statisnomo/RC-Project_P1_G9/evidence/lab_2026-11-04/keypad_setup.jpg

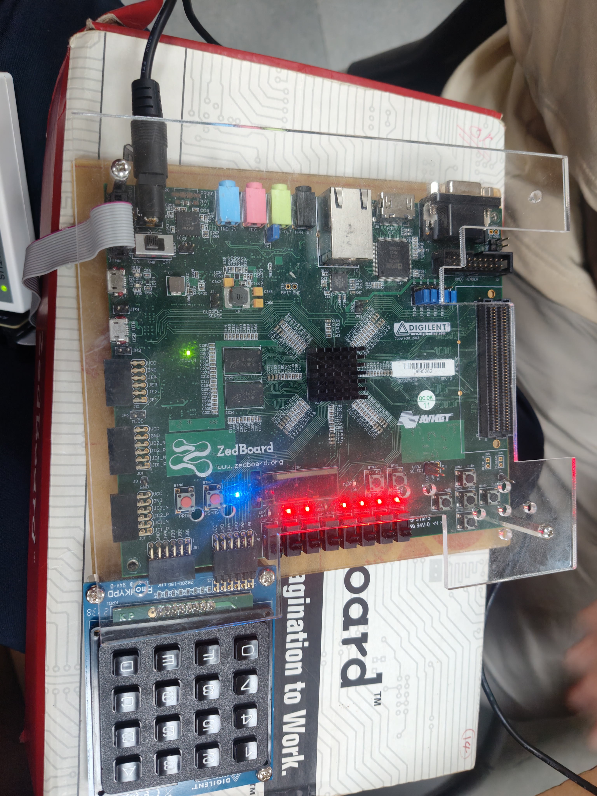
evidence/lab_2026-11-04/keypad_setup.jpg
