statisnomo/RC-Project_P1_G9/evidence/lab_2026-11-04/oled_pattern_close.jpg

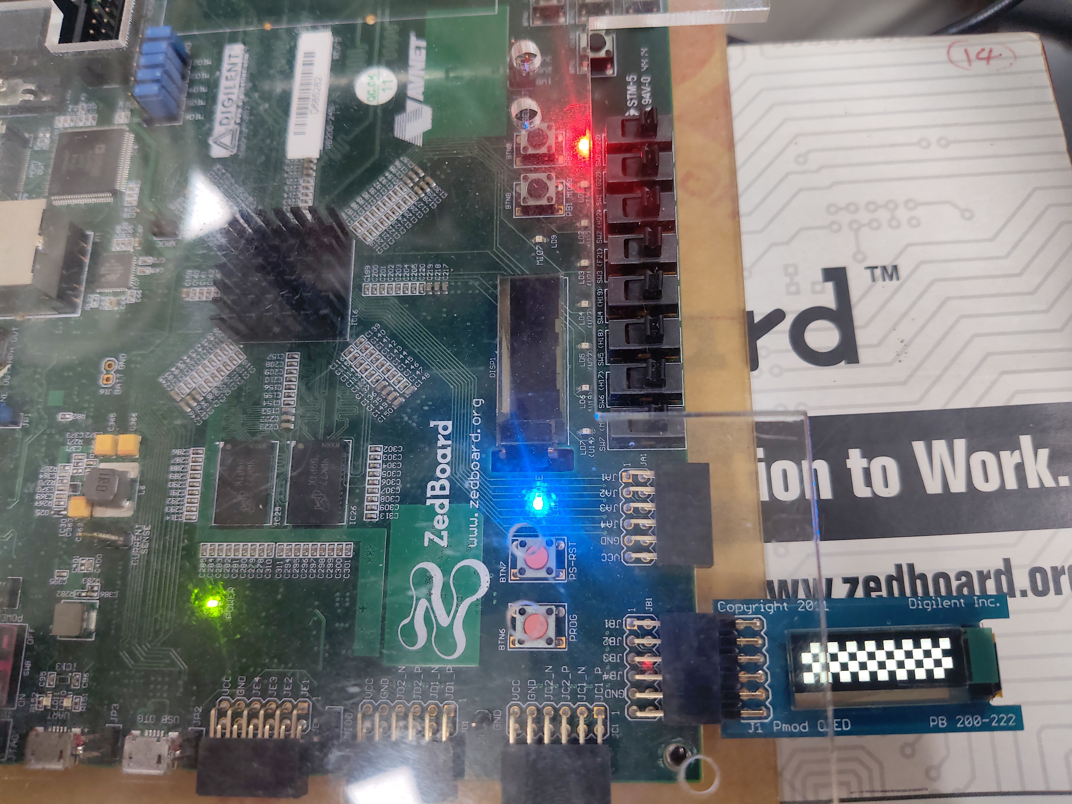
evidence/lab_2026-11-04/oled_pattern_close.jpg
