statisnomo/RC-Project_P1_G9/README.md

# Custom RISC-V SoC with a Cryptographic Hardware Accelerator

**Presentation build — November 6:** the same custom CPU now runs software
AES and controls the hardware AES for a measured comparison: 24,576 versus
213 cycles at wait setting 1. Both paths matched 413 independently checked
inputs in each of two bus configurations. This is simulation-verified; live
OLED comparison integration is next. See [GUI tests 28–30](docs/benchmark.md),
[the presentation plan](docs/presentation_plan.md), and download
[the separate benchmark development ZIP](https://github.com/statisnomo/RC-Project_P1_G9/raw/refs/heads/main/deliverables/riscv_soc_benchmark_dev_2026-11-06.zip).
Open `docs/presentation_demo.html` locally for the offline comparison/bit-change view.

**Next lab:** [hardened JA keypad + JC OLED kit and GUI procedure](NEXT_LAB_COMBINED.md), with tests 21–26 and expanded physical checks. [Optional UART side test](LAB_UART_OPTIONAL.md). [November 4 lab results](docs/lab_results_2026-11-04.md).

**November 5 lab PASS:** tests 21–26 and correctly rendered combined ciphertexts
on the external OLED. [Results and waveform layouts](docs/lab_results_2026-11-05.md).
The next variant uses [the ZedBoard's built-in OLED](LAB_ONBOARD_OLED.md), with
the same CPU, AES and firmware. UART hardware testing remains pending.

**November 3–4 lab:** [Build both .bit files in Vivado and test the keypad and OLED](LAB_THIS_WEEK.md).

A custom RISC-V CPU and AES-128 accelerator in the ZedBoard programmable
logic, with Pmod KYPD input, Pmod OLED output, and UART debugging.

Project started October 2, 2026. **Confirmed deadline: November 20, 2026.**
The full working demo is targeted for November 15, leaving time for fixes,
results, and rehearsal. Use the [timeline](docs/project_timeline.md),
[master checklist](docs/project_checklist.md), and
[progress log](docs/progress_log.md) to track each small verified step.

**Lab update:** tests **1–26 passed** across October 27, October 29,
November 4 and November 5. The combined external-OLED ciphertext display now
also has a user-reported physical pass. Its firmware has bounded
status waits and keypad overflow recovery. See the [release notes](docs/release_2026-11-05.md).

**Historical October recovery workflow:** [GUI checklist](NEXT_LAB.md). It covers the reported
failures in tests **6, 7, 11, 12, and 13**, including test 7's new ROM check.
Download the latest repository ZIP, then create a fresh project using
**Tools > Run Tcl Script > `scripts/create_lab_compat_project.tcl`** in lab
Vivado 2020. The [recovery notes](docs/lab_simulation_recovery.md) explain
the changes. The supplied development `.xpr` was generated with 2025.2.
For the original board procedure, use
[the October 27 lab walkthrough](docs/lab_2026-10-27.md), then
[VIVADO_START_HERE.md](VIVADO_START_HERE.md). Open
`vivado/riscv_soc_lab/riscv_soc_lab.xpr` directly only when using the tested
2025.2 installation; the lab should use its freshly generated project.
The current source adds keypad scanner test 17 and MMIO test 18 to the original sixteen sets.
See [the remaining lab tasks](docs/remaining_lab_tasks.md) for work you
can do with the already-published sixteen-test snapshot.
[LAB_START_HERE.md](LAB_START_HERE.md) retains the optional script-based workflow.

**Need the programming files from GitHub?** Open [build/](build/README.md)
for the ALU, CPU, and CPU/AES `.bit` files and their verified reports. Use
**Code > Download ZIP** to obtain the project including these builds.

The [board reference library](docs/references/zedboard/README.md) preserves
the four files supplied on October 22. The [I/O plan](docs/board_io_plan.md)
records checked pins, voltage banks, the old manual's JA3 discrepancy,
and future keypad/OLED/UART connections. Current demo pin assignments agree
with the supplied sample XDC and E.1 schematic.

The [learning path](docs/learning_path.md) recommends selected lectures,
practical tutorials, and small exercises for understanding each part of this build.

## Current milestone

**October 27: ALU, CPU, and CPU/AES passed on the ZedBoard.** The user
reported LD0 blinking, LD1 ON, and LD2-LD7 OFF for all three images,
including **3/3 AES trials**. See [the physical test record](docs/lab_results_2026-10-27.md).
The [CPU/AES guide](docs/cpu_aes_integration.md) explains the register wrapper,
four-block ROM program, integrated simulations, and LED checker. The
MMIO test passed all 284 NIST vectors with both normal and delayed replies;
CPU integration checked 32 blocks plus reset and error paths. Your personal
Vivado tests are P6-P10 in the [checklist](docs/project_checklist.md).

The October 27 lab pack includes the new CPU/AES board image with passing
routed **100 MHz timing (+0.311 ns setup / +0.159 ns hold)**. All 14 simulation
sets passed from a fresh ZIP extraction. Use the
[printable lab guide](output/pdf/lab-testing-guide-2026-10-27.pdf) and
[board build record](docs/zedboard_aes_demo.md).

The standalone **AES-128 core is now implemented and simulated**. On October 24,
its primitives passed 1,810 checks and its controller passed 17,433 checks over
556 completed blocks, including 284 published NIST cases and 256 random cases.
Completion takes 11 clock periods; reset cancellation and busy-start behavior
also passed. Read the [simple AES guide and GUI procedure](docs/aes_core.md)
and [interface contract](docs/aes_interface.md). The October 26 milestone
connects this core to the CPU through the approved MMIO registers.

The first three-stage CPU now executes the documented 37-instruction subset
in simulation, using the existing ALU, register file, decoder, and immediate
generator. `soc_minimal.v` connects it to 4 KB instruction ROM, 4 KB data RAM,
and an external MMIO port covering the four approved peripheral windows.
The [CPU milestone guide](docs/cpu_pipeline.md) explains each new file,
the bus rules, and how to run the first assembly program.

On October 20, 2026, the CPU integration tests passed again: 76 cases and 1,287
checked retirements, 24 memory checks, and a complete program that stores
55 in RAM and sends 56 to a delayed simulated peripheral exactly once.
The new [CPU board demonstration](docs/zedboard_cpu_demo.md) adds a result
checker, heartbeat/PASS/FAIL LEDs, simulation, constraints, and build scripts.
Its simulation passed the real CPU program and 15 checker scenarios.
The **UART transmitter and MMIO wrapper now pass their independent tests**:
840 core frames and 564 bus-driven frames, plus reset-abort recovery.
Use [the small UART GUI test](docs/uart_tx.md) for the next lesson. Keypad,
OLED, UART-to-CPU integration, and full demonstration firmware remain to be built.
The [physical lab record](docs/lab_results_2026-10-27.md) now confirms the
user-observed CPU self-test PASS.

Dedicated branch comparisons and memory-address addition improved the
preliminary 100 MHz setup slack from **-3.098 ns to +0.940 ns**. Synthesis
confirms two block RAMs and no inferred latches. The complete CPU board build
also meets **100 MHz after routing**, with **+0.221 ns setup slack** and
**+0.151 ns hold slack**. Its ready-to-program image is
`build/zedboard_cpu_demo/zedboard_cpu_demo.bit`. The CPU board guide records
the retained PS7 warning, verification results, and physical lab checks.

All four block testbenches passed in Vivado Simulator 2025.2 on October 10,
2026. [Verification details](docs/cpu_isa.md#verified-baseline--october-10-2026)
include the coverage and limits of this result.

Read [the ALU/register-file contract](docs/cpu_blocks.md),
[the instruction subset and decode interface](docs/cpu_isa.md), and
[the approved architecture](docs/architecture.md) before pipeline integration.
The [Mohan et al. reference notes](docs/paper_notes_mohan_2025.md) record the
accessible IEEE findings and the planned end-to-end AES benchmark.

For an October 13 snapshot explaining each original lab file, read the
[beginner guide](docs/project_guide.docx) or its [plain-text version](docs/project_guide.md).
The first [ZedBoard ALU demonstration](docs/zedboard_alu_demo.md) adds an
automatic 16-vector checker, heartbeat and PASS/FAIL LEDs, pin constraints,
and simulation/build scripts. Its simulation and FPGA build passed in
Vivado 2025.2 on October 13, 2026; routed timing met 100 MHz and the `.bit`
file is in `build/zedboard_alu_demo/`. The lab guide records the retained
PS7 warning and full results. The user reported its physical PASS on October 27.

## Repository layout

```text
riscv_soc_project/
  rtl/
    cpu/             Three-stage CPU and its four constituent blocks
    soc/             CPU, memories, and external MMIO port
    board/           ALU and CPU smoke checkers with ZedBoard LED wrappers
    mem/             Instruction ROM and data RAM
    crypto/          Verified AES datapath/control and MMIO registers
    peripherals/     Keypad, OLED, and UART
  tb/
    cpu/             Self-checking CPU block simulations
    board/           ALU and CPU board simulations with injected failures
    crypto/          AES primitive/core benches and published test vectors
    programs/        CPU test programs and independent expected results
  constraints/       Active demo pin/clock assignments; templates/ is reference only
  scripts/           Reproducible Vivado FPGA build
  fw/
    linker/          Linker scripts
    src/             First assembly program; C firmware comes later
    cpu_smoke.hex    Pre-encoded instruction ROM image
  docs/              Architecture, interfaces, verification notes, and I/O plan
    references/zedboard/  Original uploaded PDFs/XDC and their hash manifest
    references/aes/       Original NIST vectors, archive, and hash manifest
```

## Run the CPU tests

From the project directory in PowerShell, use the installed Vivado tools:

```powershell
.\tb\run_cpu_tests.ps1 -VivadoBin 'D:\VIVADO\2025.2\Vivado\bin'
```

On another machine, adjust that path or omit `-VivadoBin` when the tools
are on `PATH` or `XILINX_VIVADO` is set. Generated output stays in
`build/cpu_tests/`. All four benches must print their `PASS` line; compilation,
elaboration, simulator, and self-check failures stop the script.

To learn one block at a time, add `-Test alu`, `-Test regfile`,
`-Test decode`, or `-Test imm_gen`. Add `-Waves` to record all signals in a
per-test `.wdb` file. The [testing guide](docs/testing_guide.md) walks through
the first ALU check, waveform viewing, and small tests for future lab visits.

## Run the integrated CPU

```powershell
.\tb\run_integration_tests.ps1 -VivadoBin 'D:\VIVADO\2025.2\Vivado\bin'
```

For the shortest first exercise, add `-Test soc_minimal -Waves` and inspect
the program that sums 1 through 10. See the [milestone guide](docs/cpu_pipeline.md)
for the expected results and synthesis check. Keep `tb/programs/` and
`fw/cpu_smoke.hex` in your lab copy.

## Next integration step

Simulate the CPU board wrapper with `.\tb\run_cpu_board_tests.ps1 -Waves` and
build it with `.\scripts\build_zedboard_cpu.ps1`. Use the CPU lab guide for
timing results and the expected LED pattern before programming.

The October ALU, CPU and CPU/AES self-test images have reported physical PASS:
LD0 blinks, LD1 stays on, other LEDs stay off. The combined keypad/display
image uses a different LED legend, documented in its lab guide. Current work
is the built-in OLED trial and presentation comparison, described above.
