statisnomo/RC-Project_P1_G9/evidence/lab_2026-11-05/README.md

# User-reported November 5 lab evidence

`reported_passes.txt` preserves the six PASS lines supplied in chat for tests
21–26. The user also confirmed exact ciphertext rendering on the external
Pmod OLED. See [the lab record](../../docs/lab_results_2026-11-05.md).

`wave_configs/` contains six original WCFG files from the restored
`Downloads/rercnovember5` folder, including the system bench layout omitted
from the five-file attachment list. XML parsing and source/copy hashes were
checked. `SHA256SUMS.txt` identifies the unchanged originals. These files
preserve selected signals/layout, not WDB waveform samples.

UART hardware was not tested. No physical result for the new onboard OLED
variant is claimed by this record.
