statisnomo/RC-Project_P1_G9/evidence/uart_m3_2026-10-27/synthesis/summary.txt

UART MMIO out-of-context synthesis; Vivado 2025.2
Device: xc7z020clg484-1; default divider 868; clock constraint 10.000 ns
Inferred latches: 0
Estimated worst register-to-register setup slack: 6.368 ns
Pre-route estimate only; top-level I/O delays intentionally unspecified.
CPU integration, routed timing, and physical UART operation remain pending.
