statisnomo/RC-Project_P1_G9/evidence/release_regression_2026-11-05/summary.txt

Vivado 2025.2: all 20 baseline lab simulations passed locally.
PASS tb_alu: 4142 checks
PASS tb_regfile: 2456 port checks
PASS tb_imm_gen: 14546 checks
PASS tb_decode: 7717 decode checks, all 37 instructions, 15 combinational execution checks
PASS tb_memories: 24 checks, byte lanes, boundaries, errors, reset cancellation, back-to-back requests
PASS tb_cpu_core: 76 cases, 1287 retirements, load bypass=11, stalled decode cycles=657, drained fetches=37; reset cancellation
PASS tb_soc_minimal: ROM program, sum=55, load-use=56, one delayed MMIO write, 44 retirements
PASS tb_alu_selftest: 16 vectors, result/zero fault injection, sticky failure, reset rerun, board LEDs, heartbeat
PASS tb_cpu_board: actual CPU/ROM/RAM, LED mapping, heartbeat, reset/restart, 15 checker scenarios
PASS tb_aes_primitives: 1810 checks; all 256 S-box entries, state transforms, 10 published round keys, normal/final rounds
PASS tb_aes128_core: 17433 checks, 556 completed blocks; 284 NIST, 256 random, 11 reset-abort points; latency=11 clocks, earliest restart=12 clocks
PASS tb_aes_mmio: 1/3 wait edges, 284 NIST blocks per mode, byte strobes, access errors, busy writes, held requests, reset cancellation
PASS tb_soc_aes: real CPU/ROM/RAM/AES, 1/5 wait edges, 32 checked blocks, restart and firmware error paths
PASS tb_aes_board: four actual CPU-driven blocks, reset/restart, heartbeat/LEDs, 13 monitor scenarios
PASS tb_uart_tx: 4 dividers, 840 complete frames, 40 reset aborts
PASS tb_uart_mmio: waits 1/4, 564 complete frames, 20 reset aborts
PASS tb_keypad_scanner: 3 timing configurations, all positions, bounce, holds, rollover, chords, ghosting and reset
PASS tb_keypad_mmio: mailbox and real scanner, waits 1/4, 16 positions, ACK/event races, overflow, invalid/cancelled accesses and reset
PASS tb_keypad_aes: 64 printed digits, 64 ACKs, 2 ciphertexts in RAM, open-drain columns and chord rejection
PASS tb_oled_pattern: 1048 SPI bytes, full clear, checkerboard, power-up and timed shutdown
