statisnomo/RC-Project_P1_G9/evidence/keypad_scanner_2026-10-29/summary.txt

Vivado 2025.2; keypad scanner and minimal SoC simulations passed.
Keypad default-parameter out-of-context synthesis: no latches; 100 MHz register setup estimate 4.049 ns.
Pre-route only. MMIO, CPU integration, board constraints and physical keypad tests remain pending.
