statisnomo/RC-Project_P1_G9/build/zedboard_aes_demo/summary.txt

CPU + AES, Vivado 2025.2, xc7z020clg484-1, 100 MHz
Routed setup slack: 0.311 ns; hold slack: 0.159 ns
ROM/RAM BRAM, CPU ALU and AES hardware retained; no latches.
See drc.rpt for warnings. Physical board observation remains pending.
