statisnomo/RC-Project_P1_G9/output/pdf/lab-testing-guide-2026-10-27.pdf

Custom RISC-V SoC + AES | Lab pack: 27 October 2026 | 1 / 3

# Lab testing guide

27 October 2026 | Vivado GUI only | Target: ZedBoard XC7Z020

Aim: test three small machines in order: the ALU, the CPU, then the CPU controlling AES. Give the physical tests priority while the board is available. Simulations also work at home.

### 1. Open the complete pack

Extract riscv_soc_lab_2026-10-27.zip to a short writable folder, such as C:\RC_Lab. Keep all folders together. In Vivado 2025.2 > Open Project, choose:

riscv_soc_project/vivado/riscv_soc_lab/riscv_soc_lab.xpr
Part: xc7z020clg484-1. Zynq-7000 support and cable drivers are needed; a board-catalogue entry is not. No compiler, Python, or terminal is needed.

### 2. Connect through USB-JTAG

Use the lab's approved power supply and documented JTAG-boot setup. Ask staff to confirm the board/device and setup. Use USB-JTAG J17, not USB-UART. Keep external Pmods disconnected for these tests.

### 3. Program each image

Choose Open Hardware Manager > Open Target > Auto Connect. Select XC7Z020, then Program Device. Set the Bitstream file, leave the .ltx debug-probes field empty, and click Program.

Paths below are relative to the extracted riscv_soc_project folder. Observe each image for at least 10 seconds and save its filename plus an LED video.

[ ] ALU: fixed arithmetic/logic self-tests.

build/zedboard_alu_demo/zedboard_alu_demo.bit
[ ] CPU: real instructions, ROM/RAM, and a test MMIO device.

build/zedboard_cpu_demo/zedboard_cpu_demo.bit
[ ] CPU + AES: four encrypted blocks checked by firmware and a separate hardware observer.

build/zedboard_aes_demo/zedboard_aes_demo.bit

### Expected for every image LD0 blinking + LD1 ON + LD2-LD7 OFF

LD0 is the heartbeat; LD1 is application PASS. LD3 may finish too quickly to see. The separate configuration DONE LED does not prove that the program passed.
Repeat: program the AES image three times; confirm the same result. Reprogramming supplies a fresh startup reset. PROG clears configuration; it is not an application-reset button. Do not program flash.

# Small simulation checks

Run one block at a time | No FPGA board required

Close the old simulation. Open Simulation Settings, select the named set, confirm its top, then click Run Simulation > Run Behavioral Simulation > Run All. Read the automatic PASS line in the Tcl Console pane; do not type commands.

### [ ] First lesson: ALU

Set sim_1, top tb_alu. Expected: 4,142 checks. View operand_a, operand_b, alu_op, result, zero. The first ADD wraps ffffffff + 00000001 to zero, with zero=1.

### [ ] AES maths

Set sim_aes_primitives, top tb_aes_primitives. Expected: 1,810 checks. This checks the transformations used inside each AES round.

### [ ] AES alone

Set sim_aes_core, top tb_aes128_core. Expected: 17,433 checks / 556 completed blocks. At 25-135 ns inspect START, BUSY, DONE and ciphertext.

### [ ] AES register interface

Set sim_aes_mmio, top tb_aes_mmio. Expected: 26,632 / 48,264 checks for one/three wait edges, then PASS tb_aes_mmio. Check that a write takes effect only at a clock edge with VALID and READY high.

### [ ] CPU controls AES

Set sim_soc_aes, top tb_soc_aes. Expected: 32 healthy blocks plus error/reset checks, then PASS tb_soc_aes. Under normal_bus/dut, add mmio_* and aes_busy/aes_done to the waveform.

### [ ] Board wrapper

Set sim_aes_board, top tb_aes_board. Expected: 13 monitor scenarios plus real program, restart and LED checks, then PASS tb_aes_board.

### What to look for in the CPU/AES waveform

A completed write of 1 to 40000000 starts AES. Reads at 40000004 poll status. Reads at 40000030-4000003c fetch ciphertext. Use hexadecimal radix. The first full ciphertext is:

69c4e0d86a7b0430d8cdb78070b4c55a

These benches deliberately inject faults. Judge the final PASS, not a temporary fault signal. A $finish after PASS is normal. If time stays at 0 ns, click Run All. Save PASS screenshots and a waveform.

The full VIVADO_START_HERE.md covers all 14 sets, including register file, decoder, immediate generator, memories, and CPU regression. The folder docs/ contains the detailed lab procedure and editable record sheet.

# Record the lab result

Tick only what you personally observe | Keep separate records for each image

Date/time: ____________________ Vivado version: ____________________

Board revision / detected device: ____________________________________

Source changed or supplied images used? _____________________________

### ALU

[ ] LD0 blinking [ ] LD1 ON [ ] LD2-LD7 OFF Result: PASS / FAIL / NOT TESTED

Image used / video location: _________________________________________

### CPU

[ ] LD0 blinking [ ] LD1 ON [ ] LD2-LD7 OFF Result: PASS / FAIL / NOT TESTED

Image used / video location: _________________________________________

### CPU + AES

[ ] LD0 blinking [ ] LD1 ON [ ] LD2-LD7 OFF Result: PASS / FAIL / NOT TESTED

Image used / video location: _________________________________________

AES repeat checks: 1st _________ 2nd _________ 3rd _________

Simulation PASS screenshots / waveform: ______________________________

### If a test fails

Record the first error, exact image name, and all eight LEDs. For the AES image, LD7:LD4 encode the first fault if LD2 is on. Save the pattern; docs/zedboard_aes_demo.md explains the codes. If Vivado cannot find the device, ask staff to check power, data cable, JTAG connector, drivers, and boot setup.

### Information to collect for the next build

No additional ZedBoard files are needed for today's LED tests. Your device overview, user guide, E.1 schematic, and sample XDC are already in docs/references/zedboard/.

[ ] Board front/back photos, revision label, FPGA marking, and current jumper positions. Obtain matching board documentation if the revision differs from the supplied E.1 schematic.

[ ] Keypad and OLED model/revision, front/back photos, pin-1 markings, and actual keypad key legends. Confirm external Pmod OLED versus the board's built-in display.

[ ] Matching Pmod manuals/schematics and any adapter/extension-cable pinout available in the lab. Official reference links are saved in docs/references/pmods/README.md.

[ ] For later PL UART: adapter model, pinout and confirmed 3.3 V logic. No UART adapter is needed for these tests.

### Engineering status

CPU/AES simulation passes. The supplied AES image meets routed 100 MHz timing: +0.311 ns setup / +0.159 ns hold; DRC has zero errors and the documented PL-only ZPS7-1 warning. Physical results remain pending until observed.

Update docs/lab_record_template.md, docs/progress_log.md and checklist tasks P1/P2/P4-P10/H2 only for tests completed. Next: independently tested UART, keypad and OLED controllers.
