statisnomo/RC-Project_P1_G9/docs/progress_log.md

# Project progress log

Deadline: **20 November 2026**. Use India time for dates.
Task IDs refer to [project_checklist.md](project_checklist.md).

## 3 November 2026 — lab projects for both Pmods

Built the CPU keypad firmware path to AES and RAM, plus a standalone external OLED checkerboard with automatic shutdown. Tests 17–20 passed on development Vivado 2025.2. Each project now has a GUI setup entry point for editing and generating its own bitstream on the lab PC. [Local evidence](../evidence/week_2026-11-03/README.md) and [the lab procedure](../LAB_THIS_WEEK.md) distinguish development verification from the pending lab checks P18–P24.

## 23 October 2026 — plan established

- Deadline updated to November 20; working full-demo target November 15. 
- Existing nine-test summary, board build records, and reference audit reviewed.
- B1-B12 reflect saved verified results. They are not fresh test runs today.
- Physical board observations remain pending. M1-M7 are planned work.
- Next development action: M1.2, AES interface and byte-order contract.
- Next lab action: P4/P5, observe the existing ALU and CPU demos.
- Lab reservations and exact submission time remain to be confirmed.

## 24 October 2026 — standalone AES accepted

- Tasks **M1.1-M1.6 and G1 passed**. User selected 32 hexadecimal digits;
  fixed demo key, clear behavior, and display format recorded in the contract.
- Added six AES hardware modules, an independent mathematical reference,
  two testbenches, and original NIST known-answer files with hash manifest.
- Vivado `sim_aes_primitives`: **1,810 checks passed**.
- Vivado `sim_aes_core`: **17,433 checks / 556 completed blocks passed**,
  including 284 published NIST answers, 256 random cases, and eleven
  reset-abort locations with recovery. Verified 11-clock latency and
  earliest next acceptance after 12 clocks.
- Existing `sim_cpu_board` rerun: **15 checker scenarios passed**.
- Standalone synthesis: **1,314 LUTs, 390 FFs, zero BRAM/DSP/latches**.
  Estimated register setup slack **+4.976 ns** at a 10 ns clock constraint.
  Out-of-context synthesis does not establish routed/physical timing.
- Evidence: `evidence/aes_m1_2026-10-24/`; synthesis reports/checkpoint in
  `build/aes_synthesis/`. GUI project now has eleven simulation sets.
- Fresh ZIP extraction: both AES sets and the CPU board test passed again
  without repairing the saved project. The October 24 lab ZIP contains
  the references, source, tests, wave databases, reports, and updated plan.
- Next development action: **M2.1**, define AES MMIO access and command
  semantics, then verify the wrapper before CPU integration.
- Next lab action remains **P4/P5**, observe the existing ALU/CPU images.
  AES board-image creation and all physical observations remain pending.

## 26-27 October 2026 — CPU/AES integration and lab pack

- Tasks **M2.1-M2.6 and G2 passed**. Added AES MMIO register semantics,
  wrapper, CPU integration, four-block ROM firmware, independent LED
  observer, three simulations, and an AES board top using existing LED pins.
- MMIO passed **26,632 / 48,264 checks** with one/three wait edges.
  Both include 284 NIST answers, busy/reset/access-error cases, and
  acceptance checks at the encryption-completion boundary.
- CPU/AES simulation passed **32 healthy blocks**, reset/restart, and
  mismatch, timeout, and missing-peripheral fault paths. The real board
  wrapper and **13 observer scenarios** also passed.
- Firmware uses **880 ROM bytes / 68 RAM bytes**. Corrected status ordering:
  RAM status is committed before x31 announces success. GNU linking and
  C startup are not claimed; the ready ROM is generated from checked encodings.
- Initial board routes missed 100 MHz. Capturing MMIO requests during the
  existing wait cycle fixed the long CPU-address-to-response path. The
  final route passes **+0.311 ns setup / +0.159 ns hold**, with no internal
  unconstrained endpoints. DRC has zero errors and the retained ZPS7-1 warning.
- Generated `build/zedboard_aes_demo/zedboard_aes_demo.bit`; 3,182 LUTs,
  2,084 flip-flops, two RAMB36 blocks, zero DSPs and no inferred latches.
- Added personal Vivado tasks **P6-P10**, the October 27 lab walkthrough,
  and a record sheet for three separate board tests. Personal observations
  and **H2 remain unchecked** until the user performs them.
- Evidence: `evidence/aes_m2_2026-10-27/`; board reports are beside the image.
- Fresh extraction of the lab ZIP passed **all 14 simulation sets** with
  every registered source inside the extracted copy, without project repair.
  Added a three-page printable guide and visually checked all pages.
- Next development stage: **M3**, UART/keypad/OLED unit tests and exact
  module identification before wiring. No new peripheral pins are enabled.

## 27 October 2026 — previous lab conversation reviewed

- Source: [shared lab conversation](https://chatgpt.com/share/6ae05561-14e0-83ee-b1e8-a38ddfce4c4d).
  Actual visit date is not confirmed; this is the review date.
- User reported PowerShell script execution being blocked, then moving to
  Vivado GUI and finding no `.xpr` in the lab copy. The other assistant's
  missing-`cases.vh` comment concerned the files uploaded to that chat.
- User reported programming a bitstream and a blinking LED. Recorded as
  **reported board activity**, with exact image and functional result
  unconfirmed. No explicit simulation PASS or LD1/LD2 observation was supplied.
- Follow-up answer: the user remembers only an LED blinking. The earlier
  image and PASS/FAIL states remain unknown; no functional gate is closed.
- Inspected the current ZIP: `.xpr`, 14 simulation sets, `cases.vh`, 126 CPU
  program-data files, shared definitions, ROMs and AES vectors are present.
  Existing fresh-extraction evidence records 14 passing development tests.
- Added [lab follow-up notes](lab_followup_2026-10-27.md). P1/P2/P4/P5/H2
  remain open. Next personal check: identify the programmed image and
  record heartbeat, PASS/FAIL LEDs, and a video; use the prepared GUI project.

## 27 October 2026 — three physical board demos passed

- User confirmed following the testing guide and successfully running all
  three `.bit` files: ALU, CPU, and CPU plus AES.
- All showed **LD0 blinking, LD1 ON, LD2-LD7 OFF**. AES passed **3/3 trials**.
- **P4, P5, and H2 passed** on the strength of these reported physical
  observations. M2 now has both engineering and physical acceptance.
- Saved [the lab result](lab_results_2026-10-27.md). Media archiving and
  the standalone CPU repeat are tracked separately; personal simulation
  checks were not reported. Exact restart methods were not supplied.
- Next small build step: UART TX and its MMIO wrapper, with independent
  serial decoding tests and a Vivado GUI walkthrough. Adapter availability
  may be assumed for planning; its model/3.3 V logic remains to be checked
  before wiring, as agreed with the user.

## 27 October 2026 — UART transmitter and registers accepted

- **M3.2 passed**. Added `uart_tx` and `uart_mmio`, with the register and
  reset contract defined before RTL. Default is 100 MHz / 868, approximately
  115200 baud, 8N1, one byte at a time with BUSY polling.
- The transmitter test passed **840 complete frames / 40 reset aborts**
  across dividers 1, 2, 7, and 868. The MMIO test passed **564 frames /
  20 reset aborts**, with 1,454 and 1,457 bus checks for waits 1 and 4.
- Pin-level checking covers frame levels/durations independently of DUT
  counters. Busy writes, byte strobes, invalid accesses, cancellation,
  continuous VALID, and completion-boundary behavior passed.
- The updated GUI project has **16 simulation sets** and starts on
  `sim_uart_tx`. Existing CPU and CPU/AES board simulations also passed.
- Standalone UART/MMIO synthesis: **55 LUTs, 37 FFs, zero latches/BRAM/DSP**,
  estimated register setup slack **+6.368 ns**. This is not a routed board result.
- Added personal GUI tasks **P13/P14** and [the UART walkthrough](uart_tx.md).
  Saved [UART evidence](../evidence/uart_m3_2026-10-27/README.md).
- Next development step: **M3.3**, keypad scanning and event handling.
  H3.1 still needs a UART board build and actual serial reception. The
  user's adapter availability assumption supports planning, not wiring verification.

## 27 October 2026 — lab simulation failures reported

- User supplied forwarded test output and confirmed using the supplied
  `.xpr` in **Vivado 2020** (minor version not stated). The development
  project and previous acceptance runs used **2025.2**.
- Test 6: program/reference file-open warnings with garbled names, then
  CPU fault code 1 at PC zero with an unknown instruction, at 80 ns.
- Test 11: missing NIST vector 1 at 616 ns. Test 12: missing vector at
  14030 ns. Test 13: unexpected CPU halt awaiting firmware status at 90 ns.
- Recorded these as failed personal simulation attempts. The excerpts
  suggest data loading/setup problems; the exact 2020 cause is not proven.
  No unreported simulation is marked passed. Physical P4/P5/H2 passes
  remain supported by the separate LED observations.

## 28 October 2026 — simulation data recovery prepared and checked

- Added a GUI-launched creator that builds the project in the running
  Vivado version. It checks 128 data files before project creation and
  explicitly registers ROMs, vectors, definitions, and include paths.
- CPU filenames are materialized as strings before file I/O; CPU/AES
  memory loads use explicit index bounds. Simulation-only guards report
  missing, malformed, unknown, or incomplete input before functional tests.
- **All 16 simulations passed** in a fresh project on **Vivado 2025.2**.
  Six guard scenarios passed, including five expected data rejections.
- The initial negative-test runner resumed after a time-zero fatal and
  was stopped. Guard error paths now return explicitly and tests begin
  after GUI time zero; final fault-injection runs completed cleanly.
- Saved [recovery evidence](../evidence/lab_sim_recovery_2026-10-28/README.md)
  and [the menu-only lab procedure](lab_simulation_recovery.md).
- **P15 remains open:** rerun CPU, AES core, AES MMIO, and CPU/AES in
  lab Vivado 2020 and save PASS lines plus the generated setup report.
  Local 2025.2 checks do not establish 2020 compatibility.
- Hardware RTL, firmware, constraints, and the three accepted board
  images are unchanged by this recovery; no board rebuild is requested.

## 29 October 2026 — test 7 added to the lab recovery

- The user reported that test 7 (`sim_soc_minimal`) also failed. Its
  original error text is unavailable; the user will provide it after
  the next lab run. Its exact lab cause remains unconfirmed.
- Added a file preflight and an independent comparison of all 1,024
  initialized DUT ROM words before releasing reset. This check does
  not reload the ROM or change the CPU. Later CPU faults now include
  code, PC, and value; final failures show RAM/register/count details.
- Added maintainer checks for a missing test 7 program and a deliberately
  corrupted final ROM word. These are separate from the sixteen lab sets.
- Added [NEXT_LAB.md](../NEXT_LAB.md), updated the blank lab record, and
  expanded **P15** to tests **6/7/11/12/13**. The GUI creator registers
  test 7's common header and program image automatically.
- **All 16 normal simulations and eight diagnostic scenarios passed**
  in a fresh project on **Vivado 2025.2**. Test 7 checked all ROM words,
  sum 55, load-use 56, one MMIO write, and 44 retirements. Both deliberate
  test 7 ROM failures stopped at 1 ns, before CPU execution. See
  [the saved evidence](../evidence/lab_sim_recovery_2026-10-29/README.md).
- **P15 remains open** for the five reported failures in lab Vivado 2020.
  The accepted board images and user waveform files are unchanged.

## 29 October 2026 — eight lab simulations passed

- User supplied PASS messages for tests **5, 6, 7, 11, 12, 13, 15, 16**.
  Saved them in [the lab result record](lab_results_2026-10-29.md).
- All five previously failing simulations now pass as reported in the
  lab, including test 7. Closed **P15's functional recovery gate** and
  recorded simulation completion for **P7/P8/P9/P13/P14**.
- Split supplementary setup/log archiving into **P16** and unreported
  waveform learning into **P17**, preserving the completed functional tests.
  Exact version/source revision and setup report were not supplied today;
  the lab was previously identified as Vivado 2020.
- This report concerns simulation, not new FPGA programming or UART
  hardware reception. Next implementation milestone is **M3.3, keypad scanner**.

## 29 October 2026 — keypad scanner increment passed locally

- Implemented column scanning, two-stage row synchronization, stable-scan
  debounce, one-shot position events, stable release, rollover suppression,
  multi-key lockout, and reset requiring all-release before arming.
- Tests drive a passive matrix model through the scanner's pins, including
  ghost paths. Three accelerated timing configurations pass all 16 positions
  and exact debounce thresholds; the existing minimal SoC also still passes.
- Default synthesis: 86 LUTs, 88 FFs, no latches; preliminary 100 MHz
  register setup +4.049 ns. No routed keypad image or physical test claimed.
- Added GUI test 17/P18, [scanner documentation](keypad_scanner.md), and
  [the user's parallel lab tasks](remaining_lab_tasks.md). Evidence is
  in [the scanner snapshot](../evidence/keypad_scanner_2026-10-29/README.md).
- **M3.3 remains open:** persistent events, acknowledgement, overflow,
  hex-label mapping and MMIO are the next increment. Existing board
  designs and constraints are unchanged. New work is local, not yet pushed.

## 29 October 2026 — record correction and keypad MMIO accepted

- User clarified that tests **1–4/8–10/14 passed on October 27**.
  The earlier assistant description as unreported was incorrect. All
  original tests **1–16 have reported lab PASS** across October 27 and 29.
  Corrected checklist P1/P2/P6/P10 and the lab/preparation records; waveform
  learning remains separate from functional success.
- User confirms standard **Digilent Pmod KYPD and Pmod OLED** targets.
  UART adapter remains unconfirmed; no peripheral wiring enabled.
- Added a persistent keypad event mailbox at the approved MMIO base,
  explicit ACK/overflow clear, first-event retention, and deterministic
  ACK/new-press and clear/new-overflow priorities.
- Test 18 passed **466 checks / 470 bus completions**, across waits 1/4,
  direct event tests and the real scanner driven through the matrix pins.
  Scanner test 17 and minimal-SoC regression also passed.
- Default synthesis: **137 LUTs, 83 FFs, no latches**, preliminary
  100 MHz register setup **+4.290 ns**. Zero routed/hardware claims.
  [Evidence](../evidence/keypad_mmio_2026-10-29/README.md).
- **M3.3 engineering gate complete**; P18/P19 are the new lab tests.
  CPU integration and physical-position-to-hex translation are next.
  Work remains local and has not been pushed.

## Copy for each session or lab visit

Date / start-end time:
Session type: learning / design / simulation / implementation / lab / report
Task IDs:
One intended result:

What changed:
Source/firmware snapshot or file revision:
Vivado simulation set or programmed bitstream:
Expected result:
Observed result:
Evidence file(s), screenshot(s), or video:
Status: not started / in progress / passed / blocked

First failing observation, if any:
Next smallest action:
Lab access needed for that action? Yes / No
Milestone date still achievable? Yes / Replan needed

Only after evidence is saved: update the corresponding checklist boxes.
For a blocked task, retain the partial result and exact failure instead of
marking it complete. An old pack remains a snapshot; keep this live log in
the project and include its latest copy in the next pack.

## November 4–5: physical peripheral passes and combined display

Tests 17–20 and the independent keypad/AES and OLED board demos passed (user report and photos). No lab bitstream regeneration was performed. The next combined build moves OLED to JC to fit beside the JA keypad; optional UART moves to JD1. Internal tests cover both full displayed ciphertexts and orderly chord shutdown/restart. See [development notes](development_update_2026-11-05.md).

## November 5: waveform files recovered and remaining work reconciled

All four user-supplied waveform configurations are now archived in
`evidence/lab_2026-11-04/wave_configs/`; XML parsing and source/copy SHA-256
comparisons passed. These preserve layouts, not recorded waveform samples.
M3.4 is marked complete from the existing local OLED access and captured-pixel
test evidence. P25–P28 and physical combined-display acceptance remain open.
The checklist now separates user lab work from remaining firmware robustness,
regression, measurement and submission work. No RTL or bitstreams changed.

## November 5: hardened firmware, full regression and next lab package

M4.1/M4.2/M4.4/M4.5/G4: bounded status polls and mailbox-overflow recovery
implemented. Tests 21–26 passed, including a third full block after restart,
six injected status faults, real mailbox overflow, 44 routed accesses and
20 varied complete blocks with 660 decoded UART frames. All baseline tests
1–20 passed again. Six combined tests passed from an extracted package too.

M4.6: new image generated at 100 MHz, setup +0.146 ns / hold +0.132 ns;
no DRC errors or critical warnings, known ZPS7-1 warning only. Memory use is
680 bytes code and 56 bytes RAM, no stack. M6.1 records 11 AES-core clocks
separately from 60/75 START-to-last-ciphertext-read clocks at waits 1/5.
See [the release notes](release_2026-11-05.md) and saved evidence folders.

The next lab guide adds tests 24–26, physical H1–H7, ten independently
calculated ciphertext references and optional UART side test U1. JA keypad,
JC OLED, JD1 TX remain the wiring. P25–P31 and combined physical M5 acceptance
remain pending. Cleanup removed 65 ignored caches (57,540,356 bytes) while
preserving source, evidence and distributed artifacts.

## November 5: lab acceptance recorded and onboard OLED option built

The user reported PASS for tests 21–26 and exact physical ciphertexts on the
combined JA-keypad / JC-OLED system. With the earlier reports, simulations
1–26 are now lab-passed. Six restored waveform layouts were archived with
XML and source/copy hash checks; they are layouts, not waveform recordings.
UART hardware remains not run. Exact ten-block and three-fresh-start counts,
and the user's own implementation timing, remain to be recorded.

Added a separate onboard OLED wrapper and constraints, retaining existing
CPU, firmware and peripheral implementations. Test 27 checks the built-in
display's permanently asserted CS interface, ciphertext pixels, production
UART divider and shutdown/restart. Seven display simulations passed locally.
Implementation passed at 100 MHz: +0.241 ns setup, +0.106 ns hold; 3,562 LUTs,
2,509 flip-flops, two RAMB36s; no DRC errors or critical warnings. The new lab
guide supplies the bitstream, source and GUI implementation procedure.
The original hardened JA/JC ZIP and its 44 source hashes remain unchanged.
Physical onboard OLED acceptance is pending; this is the next small lab step.

The new ZIP was extracted to a fresh folder and all seven simulations passed
again there. Every packaged file hash and all 37 packaged source hashes
were verified, including agreement with the development inputs; the public
bitstream matches the packaged bitstream. See
`evidence/onboard_extract_2026-11-05/verification.json` and its seven logs.

## November 5–6: presentation benchmark and avalanche evidence

The user requested a more demonstrable outcome. Added a separate development
SoC/ROM that runs software AES in compiled RV32I C and the existing hardware
accelerator on the same custom CPU. All 413 independent inputs passed at
each of two AES wait settings. CPU-visible complete-call times are 24,576
cycles for software and 213/234 for hardware (waits 1/5), with timer readings
independently checked against simulated clock edges. This compares a compact
byte-oriented `-Os` baseline, not the best possible software implementation.

Tests 28–30 also cover timer access/reset/wrap, a bounded hardware-status
timeout and retry, and reset during software and hardware encryption. Program
size is 2,060 bytes; maximum reported call-chain stack is 112 bytes. A 128-input
single-bit-change sweep produced 47–79 changed ciphertext bits, mean 63.265625.
The offline presentation view shows saved evidence and is not live telemetry.
Its data/interaction checks passed after fixing a Windows UTF-8 decoding issue.
Browser visual inspection was blocked by the tool's local-file URL policy.

Original display RTL, firmware and published kits are unchanged. Next is
live OLED comparison/status integration, new routed timing and physical
acceptance. No new benchmark bitstream or physical speedup is claimed.

The separate November 6 development ZIP passed all three Vivado tests again
from a fresh extraction, plus the presenter control/data checks. All 29
packaged source hashes matched the development inputs. The original onboard
and hardened external-OLED ZIP hashes are unchanged. Extracted acceptance
logs and the archive hash are in `evidence/benchmark_extract_2026-11-06/`.
