statisnomo/RC-Project_P1_G9/rtl/cpu/regfile.v

`timescale 1ns / 1ps

// RV32I integer register file: two asynchronous reads, one synchronous write.
// Reset is active-high and synchronous; reset takes priority over writes.
module regfile (
    input  wire        clk,
    input  wire        rst,

    input  wire        we,
    input  wire [4:0]  waddr,
    input  wire [31:0] wdata,

    input  wire [4:0]  raddr1,
    output wire [31:0] rdata1,

    input  wire [4:0]  raddr2,
    output wire [31:0] rdata2
);

    reg [31:0] regs [0:31];
    integer i;

    always @(posedge clk) begin
        if (rst) begin
            for (i = 0; i < 32; i = i + 1)
                regs[i] <= 32'b0;
        end else if (we && (waddr != 5'd0)) begin
            regs[waddr] <= wdata;
        end
    end

    // Reads of x0 bypass storage, including before the first reset edge.
    assign rdata1 = (raddr1 == 5'd0) ? 32'b0 : regs[raddr1];
    assign rdata2 = (raddr2 == 5'd0) ? 32'b0 : regs[raddr2];

endmodule
