statisnomo/RC-Project_P1_G9/(commit log)

2026-10-29 Harden lab simulations and include test 7 recovery
    Publish UART TX/MMIO tests, recorded board results, and GUI instructions for the next lab. Test 7 now checks the file and all initialized ROM words before CPU startup. Verified 16 simulations and eight data diagnostics with Vivado 2025.2; lab Vivado 2020 confirmation remains pending.
2026-11-04 Harden display firmware and publish expanded JA/JC lab tests with optional UART
